brianc118/ballbot-hardware/README.md

# Hardware for a self balancing ballbot

See eagle folder for PCB design files.
Requires Cadsoft Eagle 7.x and Autodesk Inventor 2015

Copyright (c) 2015 Brian Chen
