brianc118/ballbot-hardware/hardware/stl/motor holder.stl

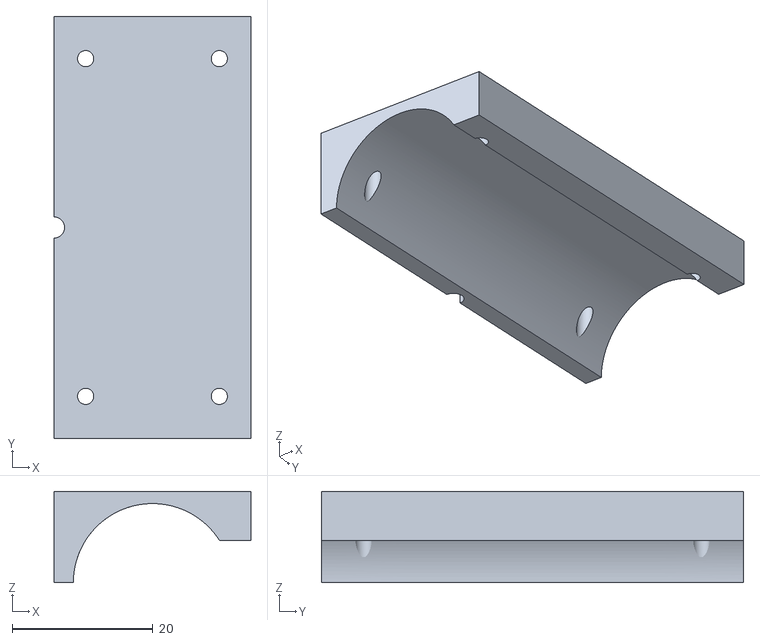
[picture p1: CAD file, 2016-01-04]
hardware/stl/motor holder.stl
28.0 x 60.0 x 13.0
