brianc118/ballbot-hardware/hardware/laser cutting/pcb.dxf

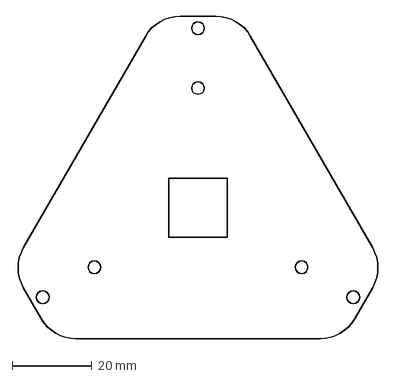
[picture p2: CAD file, 2016-01-04]
hardware/laser cutting/pcb.dxf
91.2 x 80.9 mm
