brianc118/ballbot-hardware/hardware/stl/core2.stl

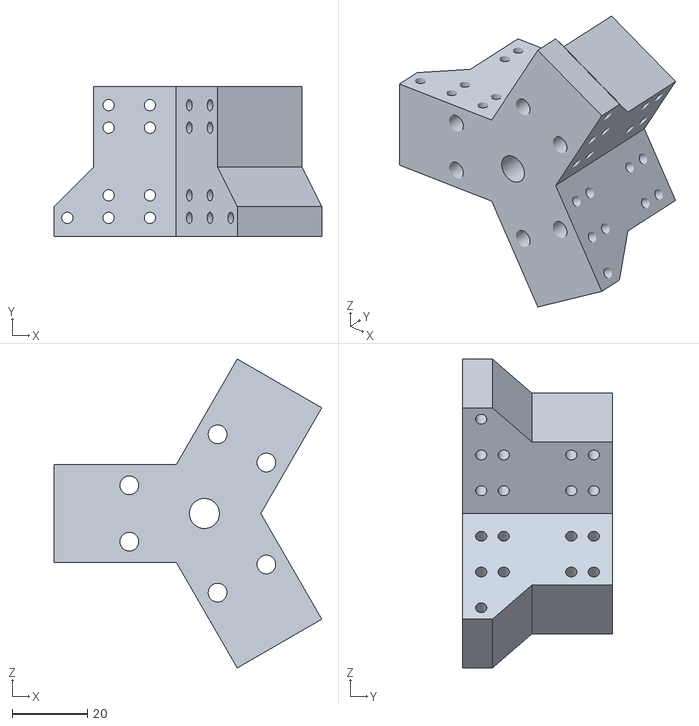
[picture p3: CAD file, 2016-01-04]
hardware/stl/core2.stl
71.3 x 40.0 x 82.3
