brianc118/ballbot-hardware/hardware/laser cutting/motor mount side.dxf

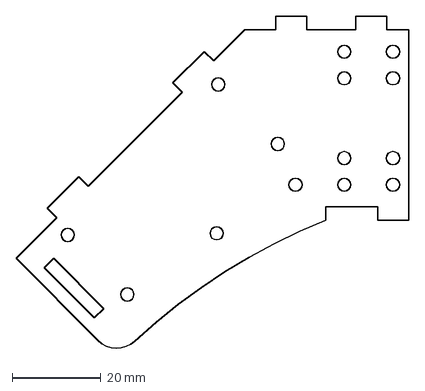
[picture p4: CAD file, 2016-01-04]
hardware/laser cutting/motor mount side.dxf
88.6 x 75.4 mm
