brianc118/ballbot-hardware/hardware/laser cutting/motor mount.dxf

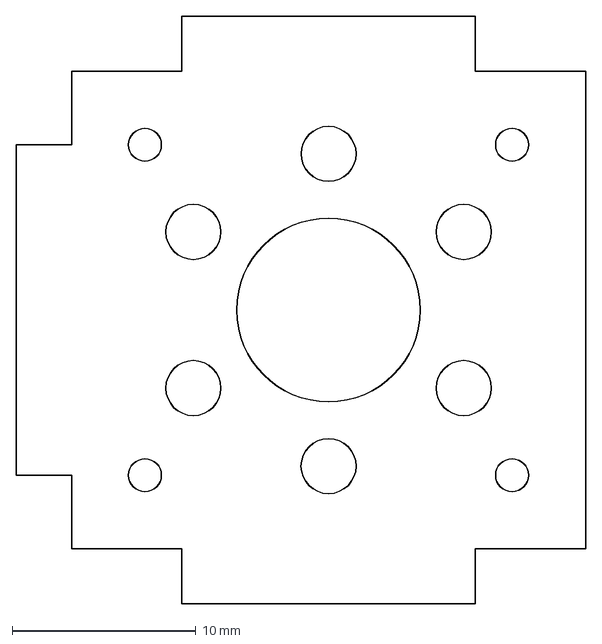
[picture p5: CAD file, 2016-01-04]
hardware/laser cutting/motor mount.dxf
31.0 x 32.0 mm
