brianc118/ballbot-hardware/hardware/laser cutting/top top plate.dxf

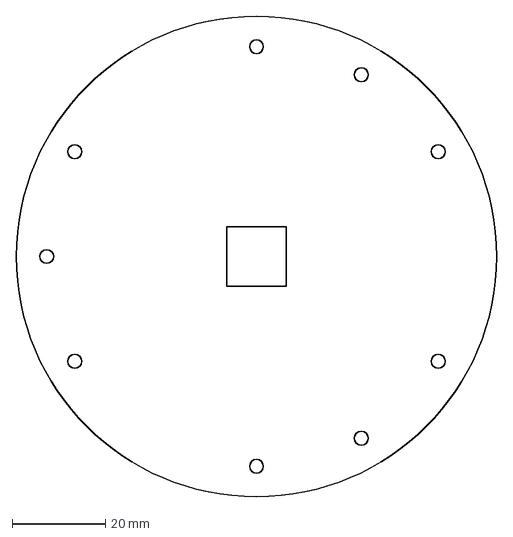
[picture p6: CAD file, 2016-01-04]
hardware/laser cutting/top top plate.dxf
103.0 x 103.0 mm
