brianc118/ballbot-hardware/hardware/laser cutting/top plate.dxf

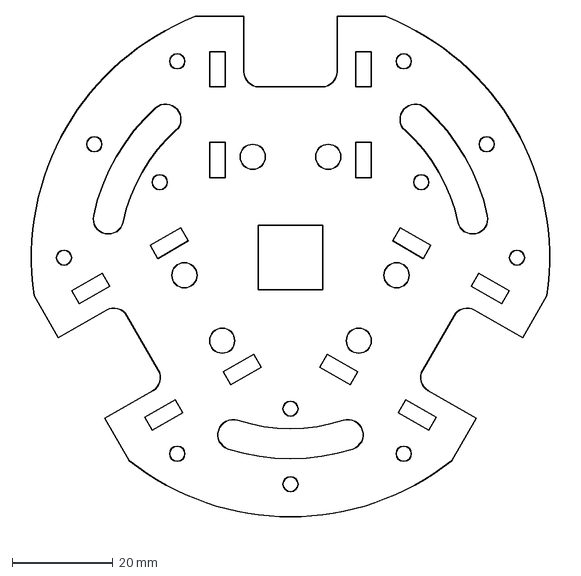
[picture p7: CAD file, 2016-01-04]
hardware/laser cutting/top plate.dxf
108.9 x 103.1 mm
