brianc118/ballbot-hardware/hardware/laser cutting/motor mount top.dxf

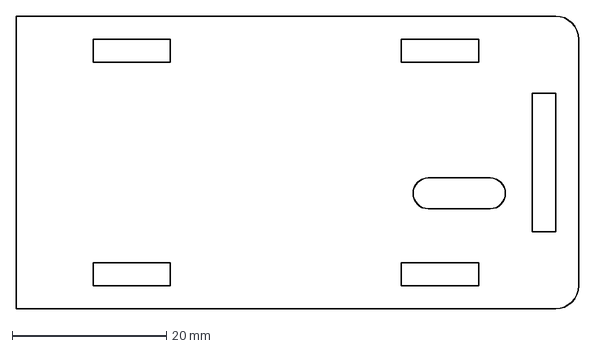
[picture p8: CAD file, 2016-01-04]
hardware/laser cutting/motor mount top.dxf
73.0 x 38.0 mm
