brianc118/ballbot-hardware/(list of files, cad)

Other CAD files:
hardware/laser cutting/laser cutting ballbot v1_part 3.dwg
hardware/laser cutting/laser cutting ballbot v1.dwg
hardware/laser cutting/laser cutting ballbot v1_part 2.dwg
hardware/18650.ipt
hardware/B7172F984DBC/1.ipt
hardware/B7172F984DBC/10.ipt
hardware/B7172F984DBC/11.ipt
hardware/B7172F984DBC/12.ipt
hardware/B7172F984DBC/1228536.ipt
hardware/B7172F984DBC/13.ipt
hardware/B7172F984DBC/14.ipt
hardware/B7172F984DBC/15.ipt
hardware/B7172F984DBC/16.ipt
hardware/B7172F984DBC/17.ipt
hardware/B7172F984DBC/18.ipt
hardware/B7172F984DBC/2.ipt
hardware/B7172F984DBC/3.ipt
hardware/B7172F984DBC/4.ipt
hardware/B7172F984DBC/5.ipt
hardware/B7172F984DBC/6.ipt
hardware/B7172F984DBC/7.ipt
hardware/B7172F984DBC/8.ipt
hardware/B7172F984DBC/9.ipt
hardware/B7172F984DBC/OldVersions/1.0003.ipt
hardware/B7172F984DBC/OldVersions/10.0002.ipt
hardware/B7172F984DBC/OldVersions/12.0002.ipt
hardware/B7172F984DBC/OldVersions/1228536.0002.ipt
hardware/B7172F984DBC/OldVersions/13.0002.ipt
hardware/B7172F984DBC/OldVersions/14.0002.ipt
hardware/B7172F984DBC/OldVersions/15.0002.ipt
hardware/B7172F984DBC/OldVersions/16.0002.ipt
hardware/B7172F984DBC/OldVersions/17.0002.ipt
hardware/B7172F984DBC/OldVersions/18.0009.ipt
hardware/B7172F984DBC/OldVersions/2.0003.ipt
hardware/B7172F984DBC/OldVersions/3.0004.ipt
hardware/B7172F984DBC/OldVersions/4.0003.ipt
hardware/B7172F984DBC/OldVersions/5.0003.ipt
hardware/B7172F984DBC/OldVersions/8.0002.ipt
hardware/B72EB14AA30C/039521104.ipt
hardware/B72EB14AA30C/039521104_MIR.ipt
hardware/B72EB14AA30C/039521104_MIR1.ipt
hardware/B72EB14AA30C/039521104_MIR2.ipt
hardware/B72EB14AA30C/1.ipt
hardware/B72EB14AA30C/10.ipt
hardware/B72EB14AA30C/10_MIR.ipt
hardware/B72EB14AA30C/10_MIR1.ipt
hardware/B72EB14AA30C/10_MIR2.ipt
hardware/B72EB14AA30C/11.ipt
hardware/B72EB14AA30C/11_MIR.ipt
hardware/B72EB14AA30C/11_MIR1.ipt
hardware/B72EB14AA30C/11_MIR2.ipt
hardware/B72EB14AA30C/12.ipt
hardware/B72EB14AA30C/12_MIR.ipt
hardware/B72EB14AA30C/12_MIR1.ipt
hardware/B72EB14AA30C/12_MIR2.ipt
hardware/B72EB14AA30C/13.ipt
hardware/B72EB14AA30C/13_MIR.ipt
hardware/B72EB14AA30C/13_MIR1.ipt
hardware/B72EB14AA30C/13_MIR2.ipt
hardware/B72EB14AA30C/14.ipt
hardware/B72EB14AA30C/14_MIR.ipt
hardware/B72EB14AA30C/14_MIR1.ipt
hardware/B72EB14AA30C/14_MIR2.ipt
hardware/B72EB14AA30C/15.ipt
hardware/B72EB14AA30C/15_MIR.ipt
hardware/B72EB14AA30C/15_MIR1.ipt
hardware/B72EB14AA30C/15_MIR2.ipt
hardware/B72EB14AA30C/16.ipt
hardware/B72EB14AA30C/16_MIR.ipt
hardware/B72EB14AA30C/16_MIR1.ipt
hardware/B72EB14AA30C/16_MIR2.ipt
hardware/B72EB14AA30C/17.ipt
hardware/B72EB14AA30C/17_MIR.ipt
hardware/B72EB14AA30C/17_MIR1.ipt
hardware/B72EB14AA30C/17_MIR2.ipt
hardware/B72EB14AA30C/1_MIR.ipt
hardware/B72EB14AA30C/1_MIR1.ipt
hardware/B72EB14AA30C/1_MIR2.ipt
hardware/B72EB14AA30C/2.ipt
hardware/B72EB14AA30C/2_MIR.ipt
hardware/B72EB14AA30C/2_MIR1.ipt
hardware/B72EB14AA30C/2_MIR2.ipt
hardware/B72EB14AA30C/3.ipt
hardware/B72EB14AA30C/3_MIR.ipt
hardware/B72EB14AA30C/3_MIR1.ipt
hardware/B72EB14AA30C/3_MIR2.ipt
hardware/B72EB14AA30C/4.ipt
hardware/B72EB14AA30C/4_MIR.ipt
hardware/B72EB14AA30C/4_MIR1.ipt
hardware/B72EB14AA30C/4_MIR2.ipt
hardware/B72EB14AA30C/5.ipt
hardware/B72EB14AA30C/5_MIR.ipt
hardware/B72EB14AA30C/5_MIR1.ipt
hardware/B72EB14AA30C/5_MIR2.ipt
hardware/B72EB14AA30C/6.ipt
hardware/B72EB14AA30C/6_MIR.ipt
hardware/B72EB14AA30C/6_MIR1.ipt
hardware/B72EB14AA30C/6_MIR2.ipt
hardware/B72EB14AA30C/7.ipt
hardware/B72EB14AA30C/7_MIR.ipt
hardware/B72EB14AA30C/7_MIR1.ipt
hardware/B72EB14AA30C/7_MIR2.ipt
hardware/B72EB14AA30C/8.ipt
hardware/B72EB14AA30C/8_MIR.ipt
hardware/B72EB14AA30C/8_MIR1.ipt
hardware/B72EB14AA30C/8_MIR2.ipt
hardware/B72EB14AA30C/9.ipt
hardware/B72EB14AA30C/919083.ipt
hardware/B72EB14AA30C/919083_MIR.ipt
hardware/B72EB14AA30C/919083_MIR1.ipt
hardware/B72EB14AA30C/919083_MIR2.ipt
hardware/B72EB14AA30C/9_MIR.ipt
hardware/B72EB14AA30C/9_MIR1.ipt
hardware/B72EB14AA30C/9_MIR2.ipt
hardware/B72EB14AA30C/B72EB14AA30C.iam
hardware/B72EB14AA30C/OldVersions/039521104.0004.ipt
hardware/B72EB14AA30C/OldVersions/1.0004.ipt
hardware/B72EB14AA30C/OldVersions/10.0004.ipt
hardware/B72EB14AA30C/OldVersions/11.0004.ipt
hardware/B72EB14AA30C/OldVersions/12.0004.ipt
hardware/B72EB14AA30C/OldVersions/13.0004.ipt
hardware/B72EB14AA30C/OldVersions/14.0004.ipt
hardware/B72EB14AA30C/OldVersions/15.0004.ipt
hardware/B72EB14AA30C/OldVersions/16.0004.ipt
hardware/B72EB14AA30C/OldVersions/17.0004.ipt
hardware/B72EB14AA30C/OldVersions/2.0004.ipt
hardware/B72EB14AA30C/OldVersions/3.0004.ipt
hardware/B72EB14AA30C/OldVersions/4.0004.ipt
hardware/B72EB14AA30C/OldVersions/5.0004.ipt
hardware/B72EB14AA30C/OldVersions/6.0004.ipt
hardware/B72EB14AA30C/OldVersions/7.0004.ipt
hardware/B72EB14AA30C/OldVersions/8.0004.ipt
hardware/B72EB14AA30C/OldVersions/9.0004.ipt
hardware/B72EB14AA30C/OldVersions/919083.0004.ipt
hardware/B72EB14AA30C/OldVersions/B72EB14AA30C.0009.iam
hardware/MAXON_DCX_MOTOR.iam
hardware/OldVersions/18650.0001.ipt
hardware/OldVersions/MAXON_DCX_MOTOR.0013.iam
hardware/OldVersions/Part3.0001.ipt
hardware/OldVersions/assembly.0028.iam
hardware/OldVersions/bottom plate.0019.ipt
hardware/OldVersions/bottom plate.0021.ipt
hardware/OldVersions/core.0001.ipt
hardware/OldVersions/core2.0020.ipt
hardware/OldVersions/motor holder.0012.ipt
hardware/OldVersions/motor mount side.0025.ipt
hardware/OldVersions/motor mount side.0027.ipt
hardware/OldVersions/motor mount top.0015.ipt
hardware/OldVersions/motor mount.0009.ipt
hardware/OldVersions/pcb.0001.ipt
hardware/OldVersions/pcb2.0002.ipt
hardware/OldVersions/soccer ball.0003.ipt
hardware/OldVersions/spacer.0001.ipt
hardware/OldVersions/top plate.0020.ipt
hardware/OldVersions/top top plate.0006.ipt
hardware/OldVersions/wheel.0005.ipt
hardware/Part1.ipt
hardware/Part3.ipt
hardware/assembly.iam
hardware/bottom plate.ipt
hardware/core.ipt
hardware/core2.ipt
hardware/laser cutting/top plate.dwg
hardware/motor holder.ipt
hardware/motor mount side.ipt
hardware/motor mount top.ipt
hardware/motor mount.ipt
hardware/pcb.ipt
hardware/pcb2.ipt
hardware/soccer ball.ipt
hardware/spacer.ipt
hardware/top plate.ipt
hardware/top top plate.ipt
hardware/wheel.ipt
