brianc118/ballbot-hardware/eagle/ballbot/ballbot.pdf

POWER CIRCUIT | DEV BOARD/uC

A

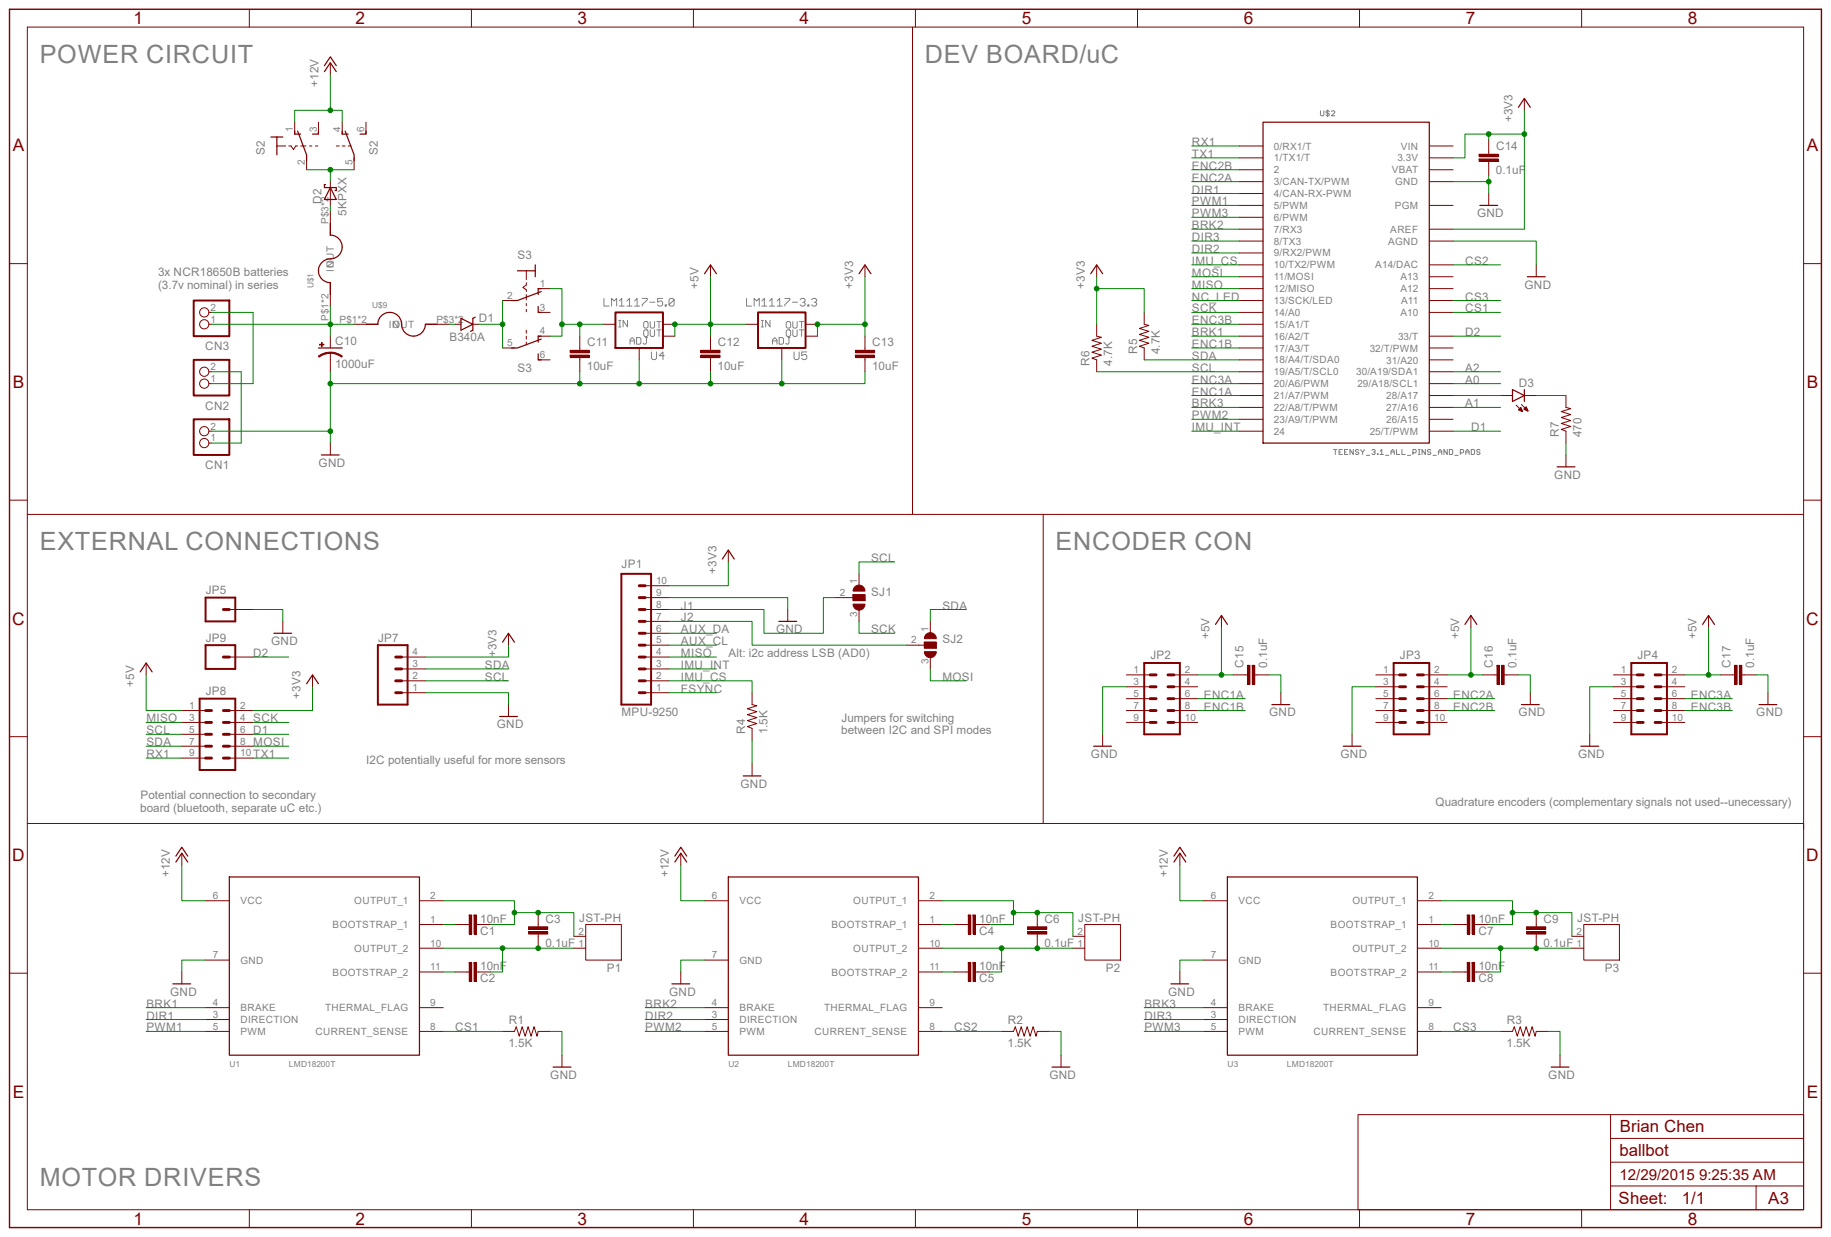
[picture p9: page 1]

Jumpers for switching
between I2C and SPI modes

I2C potentially useful for more sensors

Potential connection to secondary
