brianc118/ballbot-hardware/eagle/ballbot/ballbot.brd

## EAGLE design eagle/ballbot/ballbot.brd (2016-01-04)

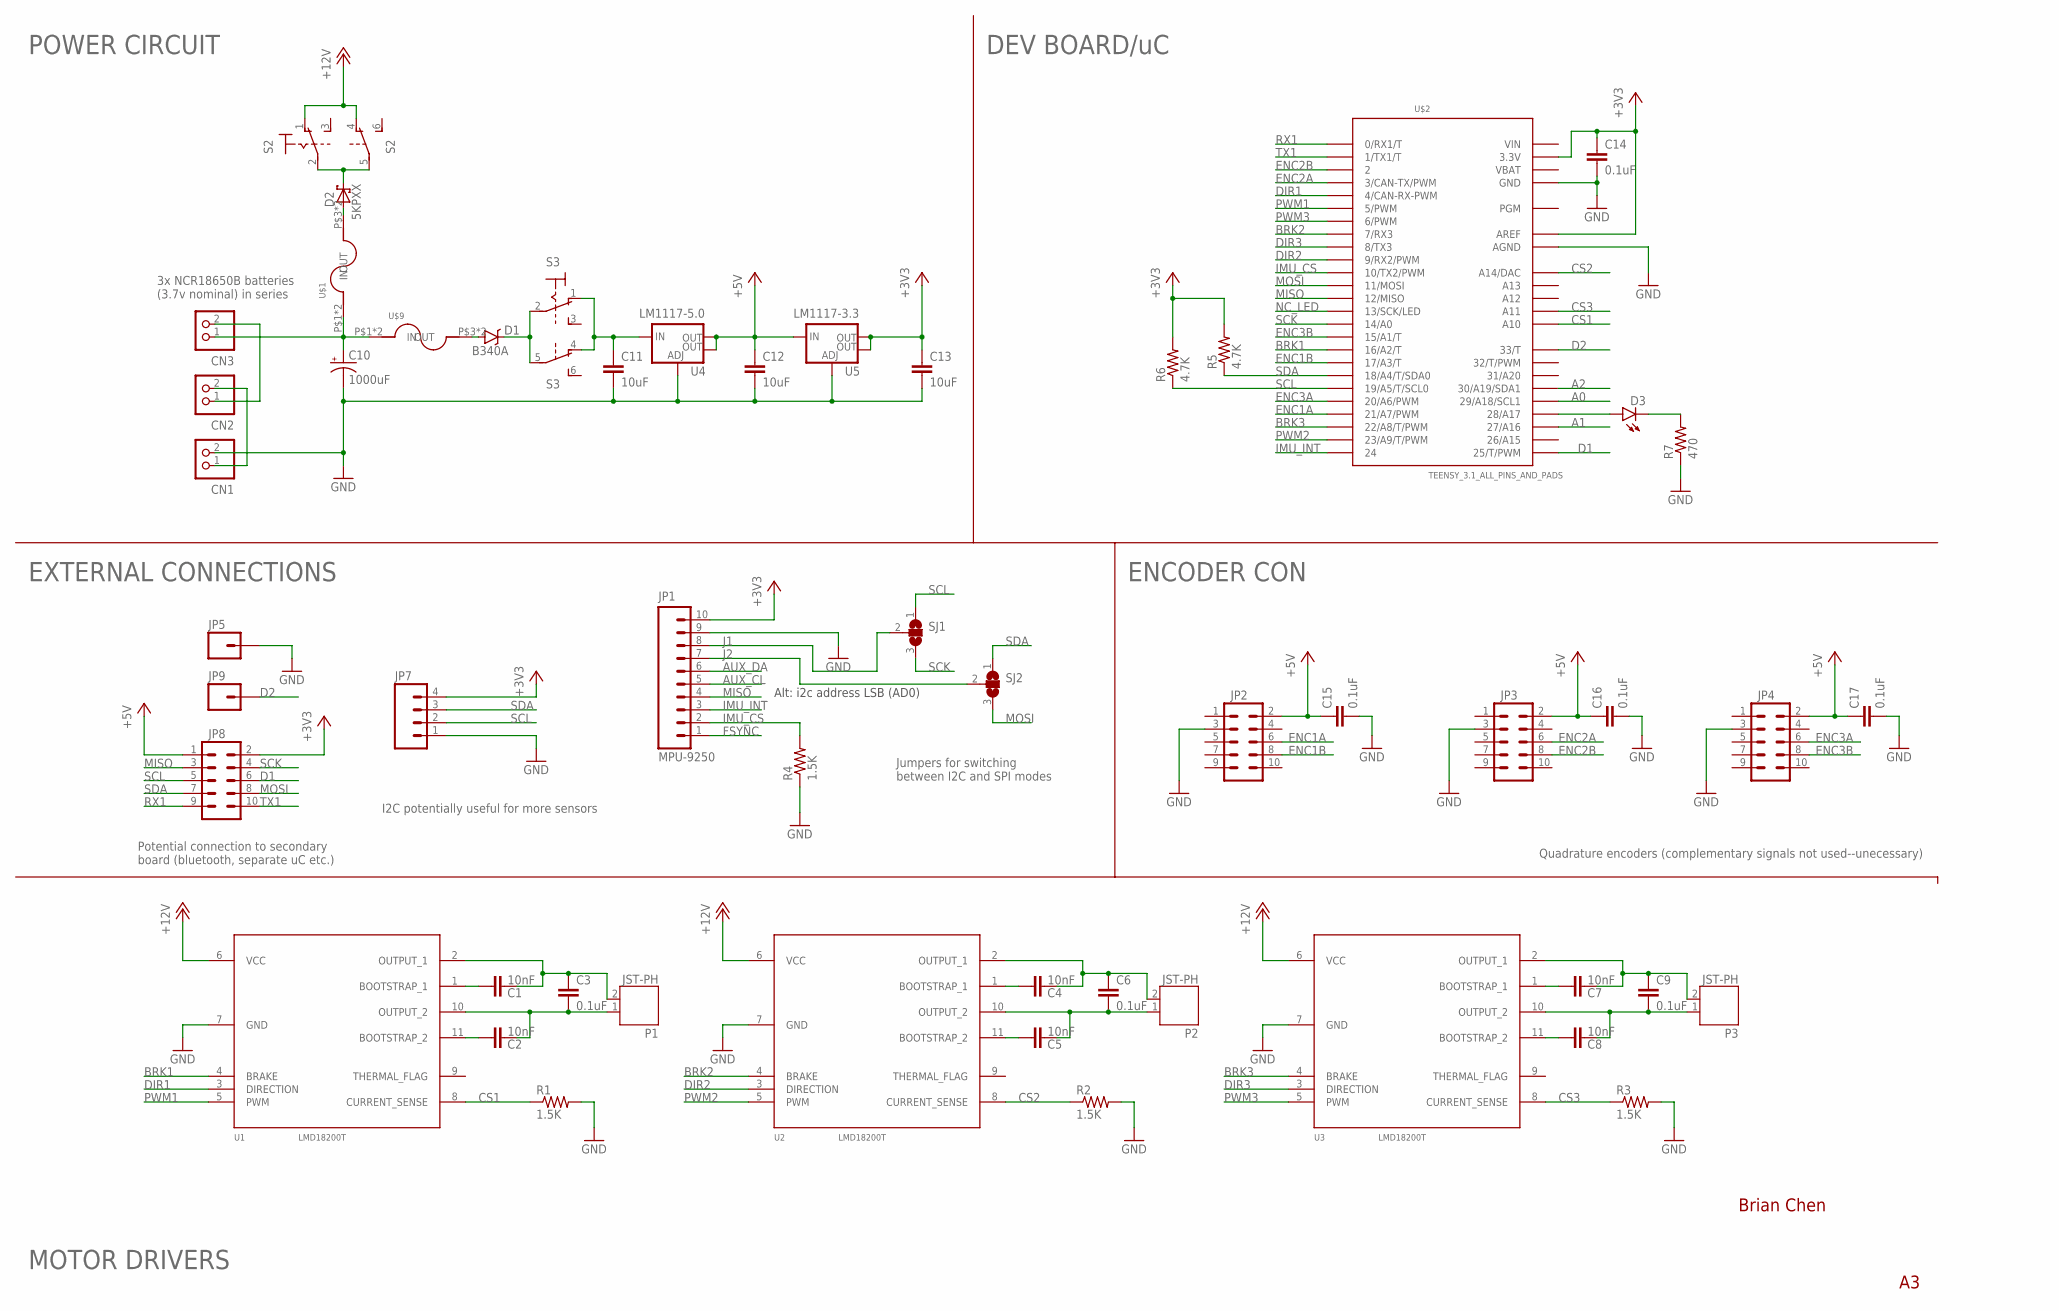
[picture p10: schematic ballbot.sch]

Parts:
C1, C2, C4, C5, C7, C8: 10nF; 0603-CAP
C3, C6, C9, C14, C15, C16, C17: 0.1uF; 0603-CAP
C10: 1000uF; CPOL-RADIAL-1000UF-25V
C11, C12, C13: 10uF; 0603-CAP
CN1, CN2, CN3: B2PS-VH
D1: B340A; SMA-DIODE
D2: 5KPXX; P6T15
D3: LED0603; LED-0603
JP1: MPU-9250; 1X10_NO_SILK
JP2, JP3, JP4: M05X2SHD; 2X5-SHROUDED
JP5, JP9: M01PTH_NO_SILK_YES_STOP; 1X01_NO_SILK
JP7: M04NO_SILK_ALL_ROUND; 1X04_NO_SILK_ALL_ROUND
JP8: M05X2NO_SILK; 2X5_NOSILK
P1, P2, P3: JST-PH; JST-PH2
R1, R2, R3, R4: 1.5K; 0603-RES
R5, R6: 4.7K; 0603-RES
R7: 470; 0603-RES
S2, S3: 320-938
SJ1, SJ2: SJ2W; SJ_2
U1, U2, U3: LMD18200T; TO-220-11
U4: LM1117-5.0; SOT223
U5: LM1117-3.3; SOT223
U$1, U$9: FUSE_HOLDER_; KEYSTONE_3568
U$2: TEENSY_3.1_ALL_PINS_AND_PADS; TEENSY3_ALL_PINS_&_PADS

Connections:
+3V3: C13.1, C14.1, JP1.10, JP7.4, JP8.2, R5.2, R6.2, U5.2 (OUT), U5.4 (OUT), U$2.3.3V, U$2.3.3V1 (3.3V), U$2.3.3V2 (3.3V), U$2.AREF
+5V: C12.1, C15.1, C16.1, C17.1, JP2.2, JP3.2, JP4.2, JP8.1, U4.2 (OUT), U4.4 (OUT), U5.3 (IN)
+12V: S2.1 (O), S2.4 (O), U1.6 (VCC), U2.6 (VCC), U3.6 (VCC)
A0: U$2.29 (29/A18/SCL1)
A1: U$2.27 (27/A16)
A2: U$2.30 (30/A19/SDA1)
AUX_CL: JP1.5
AUX_DA: JP1.6
BRK1: U1.4 (BRAKE), U$2.16/A2 (16/A2/T)
BRK2: U2.4 (BRAKE), U$2.7 (7/RX3)
BRK3: U3.4 (BRAKE), U$2.22/A8 (22/A8/T/PWM)
CS1: R1.1, U1.8 (CURRENT_SENSE), U$2.A10
CS2: R2.1, U2.8 (CURRENT_SENSE), U$2.RESET/DAC (A14/DAC)
CS3: R3.1, U3.8 (CURRENT_SENSE), U$2.A11
D1: JP8.6, U$2.25 (25/T/PWM)
D2: JP9.1, U$2.33 (33/T)
DIR1: U1.3 (DIRECTION), U$2.4 (4/CAN-RX-PWM)
DIR2: U2.3 (DIRECTION), U$2.9 (9/RX2/PWM)
DIR3: U3.3 (DIRECTION), U$2.8 (8/TX3)
ENC1A: JP2.6, U$2.21/A7 (21/A7/PWM)
ENC1B: JP2.8, U$2.17/A3 (17/A3/T)
ENC2A: JP3.6, U$2.3 (3/CAN-TX/PWM)
ENC2B: JP3.8, U$2.2
ENC3A: JP4.6, U$2.20/A6 (20/A6/PWM)
ENC3B: JP4.8, U$2.15/A1 (15/A1/T)
FSYNC: JP1.1
GND: C10.-, C11.2, C12.2, C13.2, C14.2, C15.2, C16.2, C17.2, CN1.2, JP1.9, JP2.3, JP3.3, JP4.3, JP5.1, JP7.1, R1.2, R2.2, R3.2, R4.1, R7.1, U1.7 (GND), U2.7 (GND), U3.7 (GND), U4.1 (ADJ), U5.1 (ADJ), U$2.AGND, U$2.GND, U$2.GND1 (GND), U$2.GND2 (GND)
IMU_CS: JP1.2, R4.2, U$2.10 (10/TX2/PWM)
IMU_INT: JP1.3, U$2.24
J1: JP1.8, SJ1.2
J2: JP1.7, SJ2.2
MISO: JP1.4, JP8.3, U$2.12 (12/MISO)
MOSI: JP8.8, SJ2.3, U$2.11 (11/MOSI)
unnamed: C1.1, U1.1 (BOOTSTRAP_1)
unnamed: C2.1, U1.11 (BOOTSTRAP_2)
unnamed: C4.1, U2.1 (BOOTSTRAP_1)
unnamed: C5.1, U2.11 (BOOTSTRAP_2)
unnamed: C7.1, U3.1 (BOOTSTRAP_1)
unnamed: CN1.1, CN2.2
unnamed: CN2.1, CN3.2
unnamed: C11.1, S3.1 (O), S3.4 (O), U4.3 (IN)
unnamed: D2.C, S2.2, S2.5
unnamed: D2.A, U$1.P$3 (OUT), U$1.P$4 (OUT)
unnamed: D1.A, U$9.P$3 (OUT), U$9.P$4 (OUT)
unnamed: D3.A, U$2.28 (28/A17)
unnamed: D1.C, S3.2, S3.5
unnamed: D3.C, R7.2
unnamed: C8.1, U3.11 (BOOTSTRAP_2)
NA: C10.+, CN3.1, U$1.P$1 (IN), U$1.P$2 (IN), U$9.P$1 (IN), U$9.P$2 (IN)
NC_LED: U$2.13 (13/SCK/LED)
OUT_A1: C1.2, C3.1, P1.2, U1.2 (OUTPUT_1)
OUT_A2: C4.2, C6.1, P2.2, U2.2 (OUTPUT_1)
OUT_A3: C7.2, C9.1, P3.2, U3.2 (OUTPUT_1)
OUT_B1: C2.2, C3.2, P1.1, U1.10 (OUTPUT_2)
OUT_B2: C5.2, C6.2, P2.1, U2.10 (OUTPUT_2)
OUT_B3: C8.2, C9.2, P3.1, U3.10 (OUTPUT_2)
PWM1: U1.5 (PWM), U$2.5 (5/PWM)
PWM2: U2.5 (PWM), U$2.23/A9 (23/A9/T/PWM)
PWM3: U3.5 (PWM), U$2.6 (6/PWM)
RX1: JP8.9, U$2.0 (0/RX1/T)
SCK: JP8.4, SJ1.3, U$2.14/A0
SCL: JP7.2, JP8.5, R6.1, SJ1.1, U$2.19/A5 (19/A5/T/SCL0)
SDA: JP7.3, JP8.7, R5.1, SJ2.1, U$2.18/A4 (18/A4/T/SDA0)
TX1: JP8.10, U$2.1 (1/TX1/T)
VBAT: U$2.VBAT
VIN: U$2.VIN

Notes on the sheet:
Alt: i2c address LSB (AD0)
POWER CIRCUIT
DEV BOARD/uC
EXTERNAL CONNECTIONS
ENCODER CON
MOTOR DRIVERS
Brian Chen
Jumpers for switching between I2C and SPI modes
I2C potentially useful for more sensors
Potential connection to secondary board (bluetooth, separate uC etc.)
Quadrature encoders (complementary signals not used--unecessary)
3x NCR18650B batteries (3.7v nominal) in series

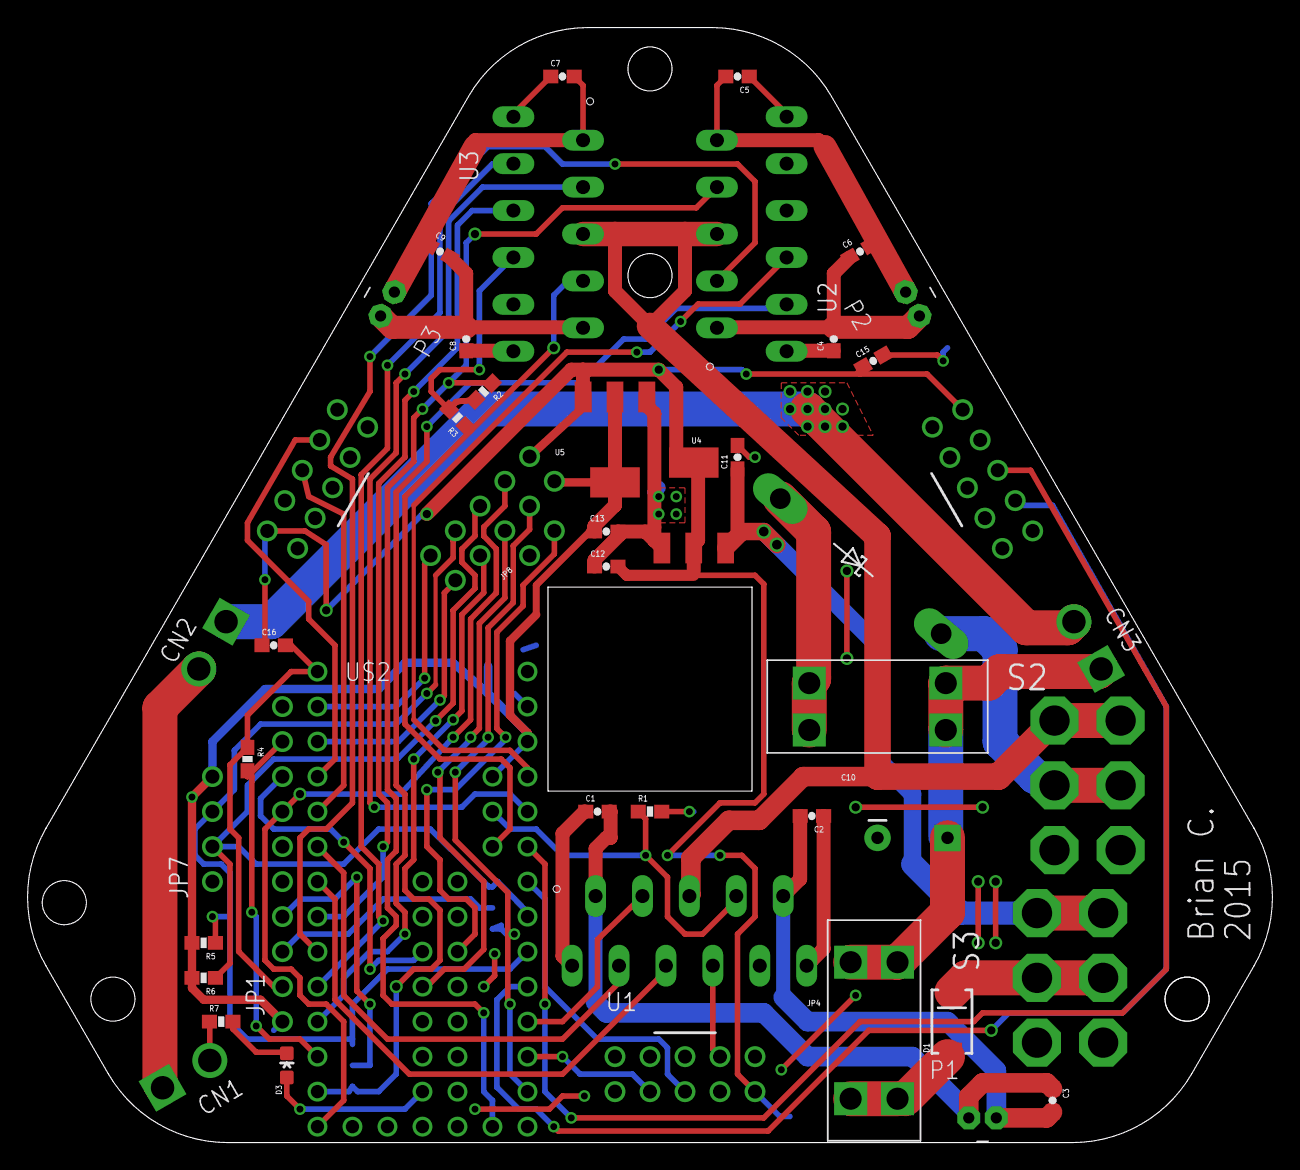
[picture p11: board ballbot.brd from above]

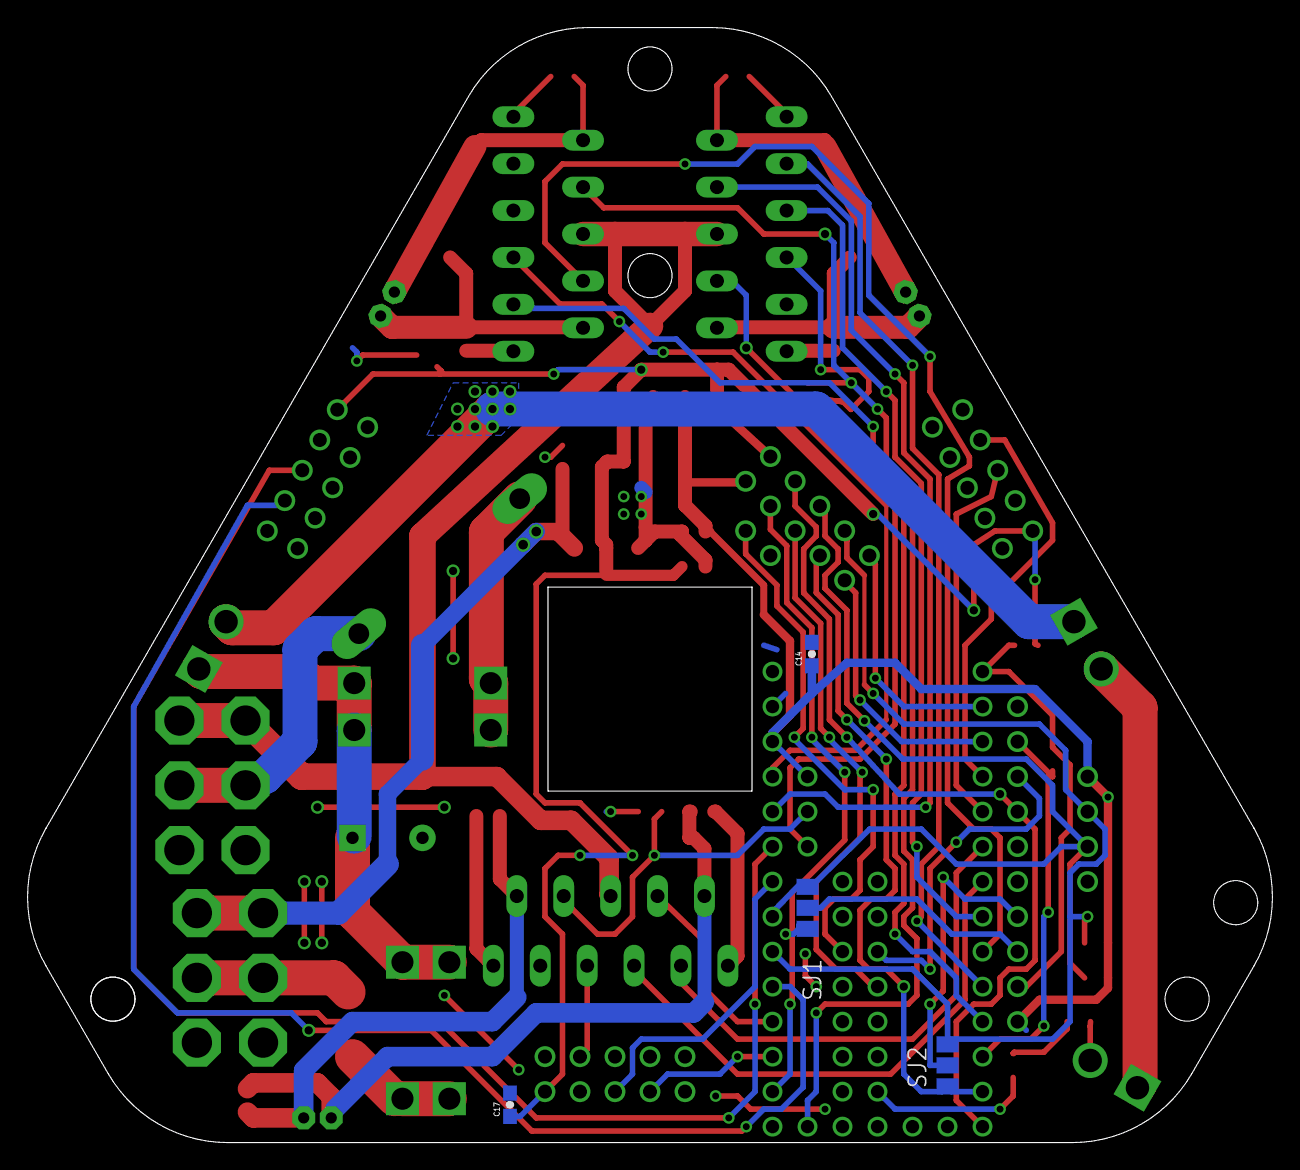
[picture p12: board ballbot.brd from below]

Board: 2 copper layers, 90.3 x 80.9 mm, 53 parts (4 on the bottom side), 57 nets.
